anasluqman089/Miirin/BOM.csv

Quantity | Reference | Part | Prices ($) | Buy Links
1 | U1 | Seeed XIAO ESP32-S3 module | 7.50 | https://www.aliexpress.com/w/wholesale-Seeed-XIAO-ESP32-S3-module.html
1 | U2 | DFRobot DFPlayer Pro (DFR0768) | 8.50 | https://www.aliexpress.com/w/wholesale-DFRobot-DFPlayer-Pro-DFR0768.html
1 | - | 1.3 Inch OLED screen | 3.50 | https://www.aliexpress.com/w/wholesale-1.3-Inch-OLED-screen.html
1 | U3 | PCF8574P I2C I/O expander | 1.20 | https://www.aliexpress.com/w/wholesale-PCF8574P-I2C-IO-expander.html
1 | D1 | Common-anode RGB LED | 0.35 | https://www.aliexpress.com/w/wholesale-Common-anode-RGB-LED.html
1 | Q1 | P-channel MOSFET | 0.80 | https://www.aliexpress.com/w/wholesale-P-channel-MOSFET.html
1 | SW6 | Rotary encoder | 0.60 | https://www.aliexpress.com/w/wholesale-Rotary-encoder.html
1 | SW5 | Momentary push buttons | 0.15 | https://www.aliexpress.com/w/wholesale-Momentary-push-buttons.html
4 | SW1-SW4 | Cherry MX Keyboard Switches | 2.00 | https://www.aliexpress.com/w/wholesale-Cherry-MX-switch.html
1 | J1 | 4-pin socket/header for the OLED | 0.10 | https://www.aliexpress.com/w/wholesale-4-pin-socket-header-for-the-OLED.html
1 | J2 | Switched 3.5 mm audio jack | 0.50 | https://www.aliexpress.com/w/wholesale-Switched-3.5-mm-audio-jack.html
3 | R4-R6 | 220 Ohm resistors | 0.15 | https://www.aliexpress.com/w/wholesale-220-Ohm-resistors.html
2 | R2-R3 | 4.7 kOhm resistors | 0.10 | https://www.aliexpress.com/w/wholesale-4.7-kOhm-resistors.html
1 | R1 | 100 kOhm resistor | 0.05 | https://www.aliexpress.com/w/wholesale-100-kOhm-resistor.html
2 | - | 100 kOhm resistors | 0.10 | https://www.aliexpress.com/w/wholesale-100-kOhm-resistors.html
2 | C1-C2 | 10 uF ceramic capacitors | 0.30 | https://www.aliexpress.com/w/wholesale-10-uF-ceramic-capacitors.html
1 | C4 | 0.1 uF ceramic capacitor | 0.10 | https://www.aliexpress.com/w/wholesale-0.1-uF-ceramic-capacitor.html
1 | C5 | 470 uF polarized capacitor | 0.45 | https://www.aliexpress.com/w/wholesale-470-uF-polarized-capacitor.html
3 | H1-H3 | M2 screw | 0.30 | https://www.aliexpress.com/w/wholesale-M2-screw.html
5 | - | M2.5 screw | 0.50 | https://www.aliexpress.com/w/wholesale-M2.5-screw.html
1 | - | PCB | 8.60 | -
4 | - | 3D print | ~10.00 | -
Total | - | - | 45.85 | -
