anasluqman089/Miirin/CAD/Assembly 1.step

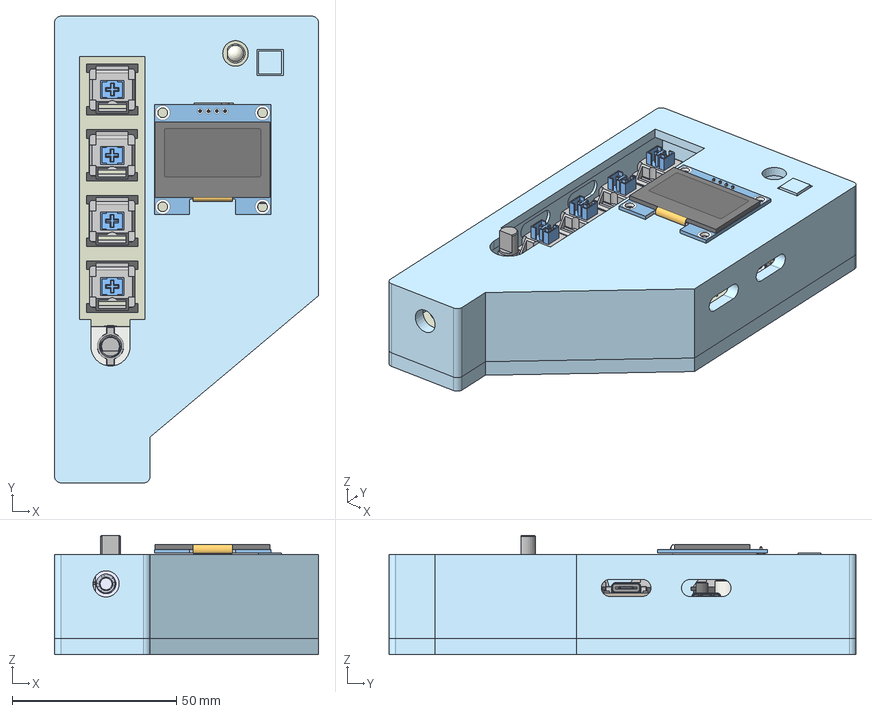
[picture p1: CAD file, 2026-10-24]
CAD/Assembly 1.step
80.4 x 142.1 x 36.4 mm
Pins:1__Solid1 x 8
Body-Move/Copy3
DFR0768 x 50
BOSS-EXTRUDE14_8_:1__K鰎per1
MAX1168CCEG+ x 25
R_Axial_DIN0207_L63mm_D25mm_P1016mm_Horizontal
Pins:1__K鰎per1_1
MIRROR2:1__K鰎per1
BOSS-EXTRUDE14_11_:1__K鰎per1
Shield:1__K鰎per1
ECS3201233QJESTR x 7
C_Disc_D43mm_W19mm_P500mm
Austragung1
BOSS-EXTRUDE14_2_:1__K鰎per1
Split2[2]
圆角3
C_Disc_D43mm_W19mm_P500mm_2
DIP-16_W7.62mm
R_Axial_DIN0207_L63mm_D25mm_P1016mm_Horizontal_5
圆角1
Body-Move/Copy1
Pins:1__K鰎per1
BOSS-EXTRUDE14_5_:1__K鰎per1
5077CR-16SMC2-BK-TR x 18
Button:1__Solid1 x 4
BOSS-EXTRUDE7_6_:1__K鰎per1
圆角4
Body:1__Solid1 x 4
TO-92_Inline_Narrow
BOSS-EXTRUDE14_7_:1__K鰎per1
CUT-EXTRUDE5:1__K鰎per1
SW_PUSH_6mm
Body:1__K鰎per1_1
R_Axial_DIN0207_L63mm_D25mm_P1016mm_Horizontal_2
BOSS-EXTRUDE7_3_:1__K鰎per1
BOSS-EXTRUDE14_4_:1__K鰎per1
BOSS-EXTRUDE14_9_:1__K鰎per1
BOSS-EXTRUDE7_1_:1__K鰎per1
BOSS-EXTRUDE7_8_:1__K鰎per1
BOSS-EXTRUDE7_5_:1__K鰎per1
Move Face1
R_Axial_DIN0207_L63mm_D25mm_P1016mm_Horizontal_1
BOSS-EXTRUDE7_4_:1__K鰎per1
BOSS-EXTRUDE7_2_:1__K鰎per1
BOSS-EXTRUDE14_10_:1__K鰎per1
PinHeader_1x04_P254mm_Horizontal
BOSS-EXTRUDE14_6_:1__K鰎per1
R_Axial_DIN0207_L63mm_D25mm_P1016mm_Horizontal_3
LED_D5.0mm-4
Pins:1__K鰎per4
Split2[4]
C_Disc_D43mm_W19mm_P500mm_1
圆角2
Miirin_PCB
圆角17
BOSS-EXTRUDE14_3_:1__K鰎per1
BOSS-EXTRUDE14_12_:1__K鰎per1
BOSS-EXTRUDE14_1_:1__K鰎per1
Pins:1__K鰎per3_1
CP_Radial_D80mm_P350mm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
