anasluqman089/Miirin/PCB/Miirin.step

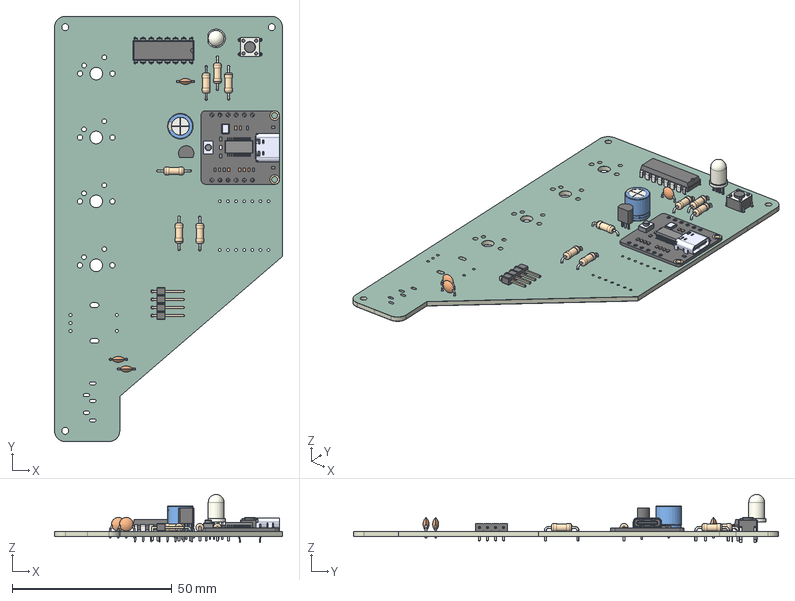
[picture p2: CAD file, 2026-10-24]
PCB/Miirin.step
71.4 x 133.1 x 15.1 mm
R_Axial_DIN0207_L63mm_D25mm_P1016mm_Horizontal x 6
DFR0768
5077CR-16SMC2-BK-TR
ECS3201233QJESTR
MAX1168CCEG+
SW_PUSH_6mm
C_Disc_D43mm_W19mm_P500mm x 3
PinHeader_1x04_P254mm_Horizontal
DIP-16_W7.62mm
TO-92_Inline_Narrow
LED_D5.0mm-4
CP_Radial_D80mm_P350mm
Miirin_soldermask x 2
Miirin_PCB
