anasluqman089/Miirin/Production/STL/Part Studio 1 - Case.stl

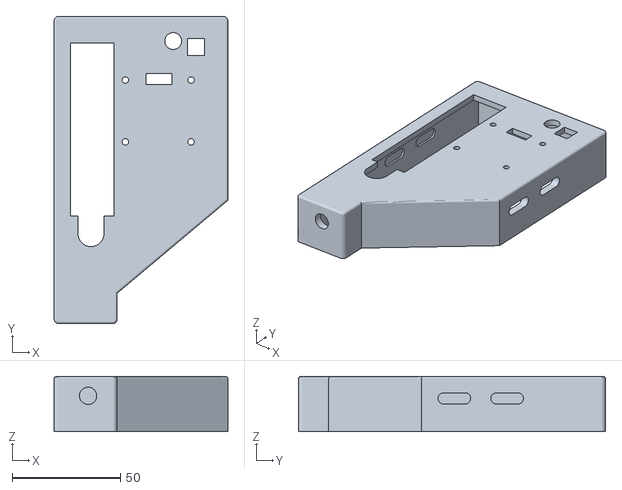
[picture p3: CAD file, 2026-10-27]
Production/STL/Part Studio 1 - Case.stl
80.4 x 142.1 x 25.5
