anasluqman089/Miirin/CAD/Part Studio 1 - Case & Flush Button.step

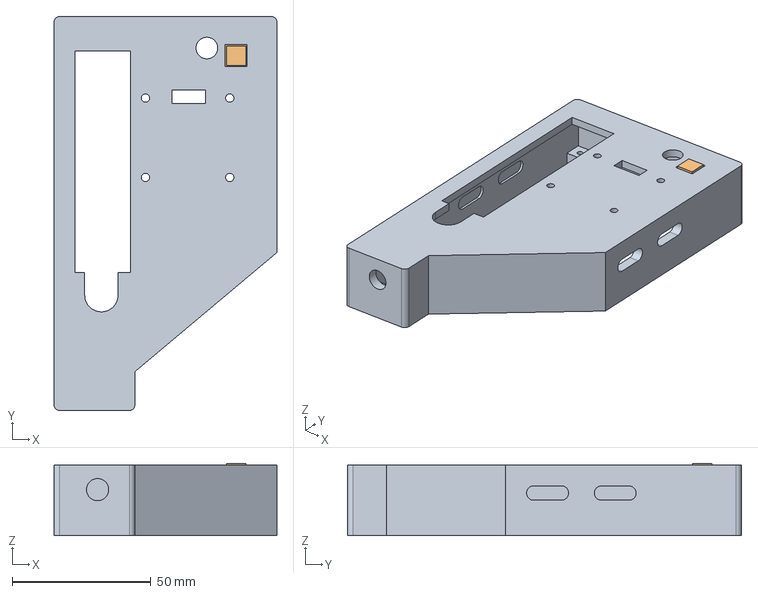
[picture p4: CAD file, 2026-10-24]
CAD/Part Studio 1 - Case & Flush Button.step
80.4 x 142.1 x 26.0 mm
