anasluqman089/Miirin/Production/STL/Part Studio 1 - Back Lid.stl

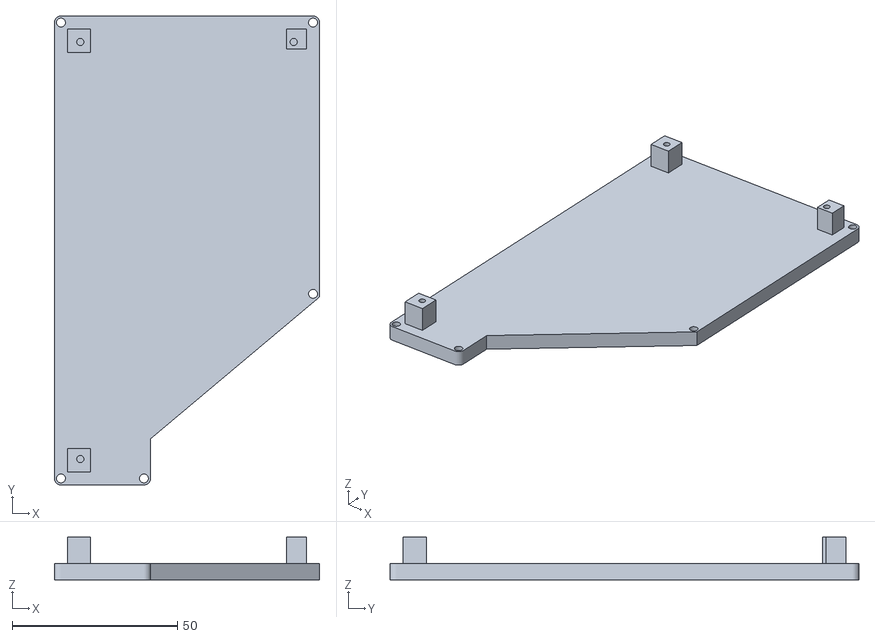
[picture p5: CAD file, 2026-10-27]
Production/STL/Part Studio 1 - Back Lid.stl
80.4 x 142.1 x 13.0
