anasluqman089/Miirin/CAD/Part Studio 1 - Back Lid.step

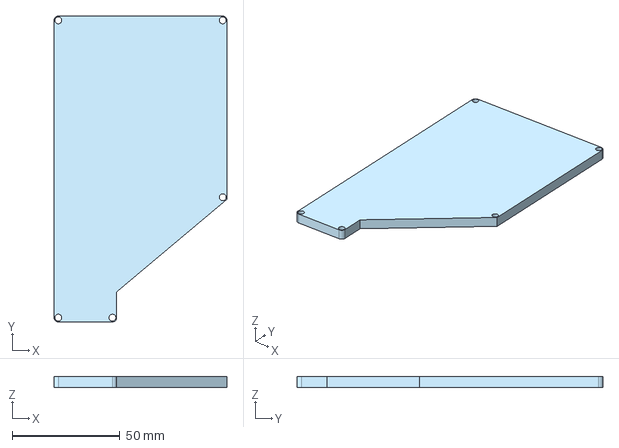
[picture p6: CAD file, 2026-10-24]
CAD/Part Studio 1 - Back Lid.step
80.4 x 142.1 x 5.00 mm
