anasluqman089/Miirin/Production/STL/Part Studio 1 - Flush Button.stl

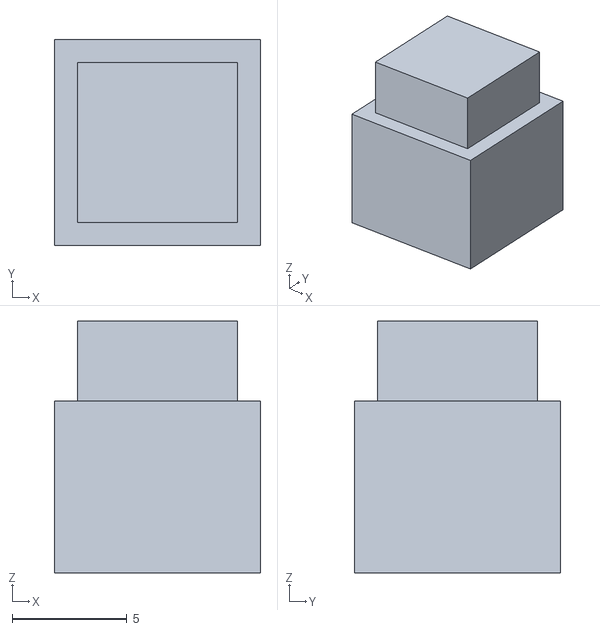
[picture p7: CAD file, 2026-10-24]
Production/STL/Part Studio 1 - Flush Button.stl
9.00 x 9.00 x 11.0
