anasluqman089/Miirin/CAD/Part Studio 1.step

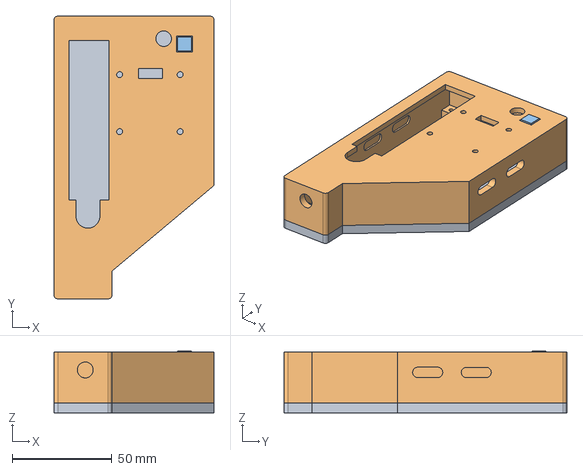
[picture p8: CAD file, 2026-10-24]
CAD/Part Studio 1.step
80.4 x 142.1 x 31.0 mm
