anasluqman089/Miirin/PCB/Miirin.kicad_pcb

## KiCad design PCB/Miirin.kicad_pcb (2026-10-24)

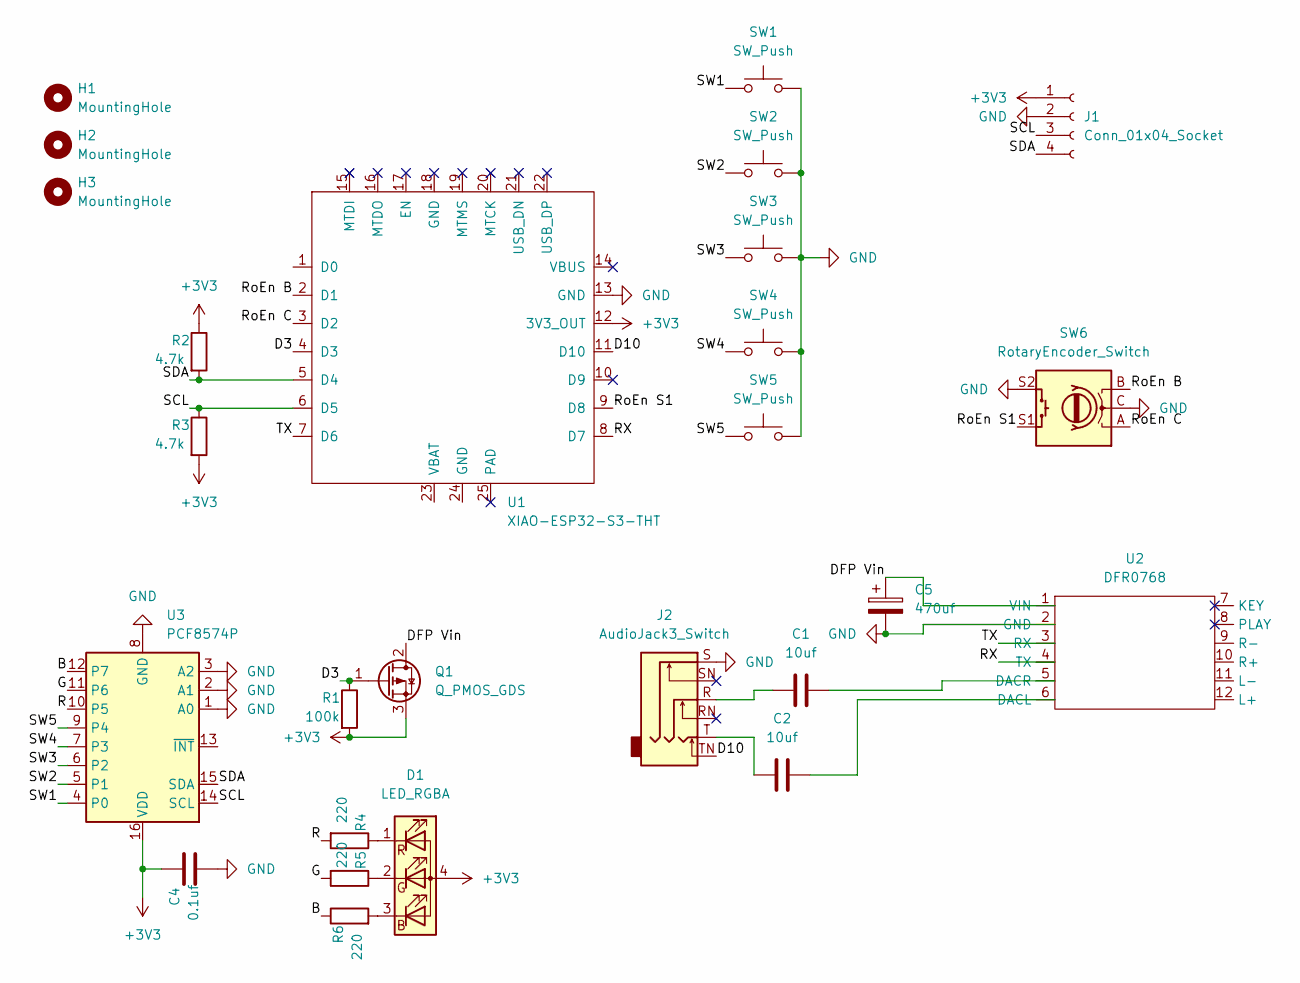
[picture p9: schematic Miirin.kicad_sch]

Parts:
C1, C2: 10uf; C_Disc_D4.3mm_W1.9mm_P5.00mm
C4: 0.1uf; C_Disc_D4.3mm_W1.9mm_P5.00mm
C5: 470uf; CP_Radial_D8.0mm_P3.50mm
D1: LED_RGBA; LED_D5.0mm-4_RGB
H1, H2, H3: MountingHole; MountingHole_2.2mm_M2
J1: Conn_01x04_Socket; PinHeader_1x04_P2.54mm_Horizontal
J2: AudioJack3_Switch; Jack_3.5mm_CUI_SJ1-3535NG_Horizontal
Q1: Q_PMOS_GDS; TO-92_Inline
R1: 100k; R_Axial_DIN0207_L6.3mm_D2.5mm_P10.16mm_Horizontal
R2, R3: 4.7k; R_Axial_DIN0207_L6.3mm_D2.5mm_P10.16mm_Horizontal
R4, R5, R6: 220; R_Axial_DIN0207_L6.3mm_D2.5mm_P10.16mm_Horizontal
SW1, SW2, SW3, SW4: SW_Push; SW_Cherry_MX_1.00u_PCB
SW5: SW_Push; SW_PUSH_6mm
SW6: RotaryEncoder_Switch; RotaryEncoder_Alps_EC11E-Switch_Vertical_H20mm
U1: XIAO-ESP32-S3-THT; XIAO-ESP32-S3-DIP
U2: DFR0768
U3: PCF8574P; DIP-16_W7.62mm

Connections:
+3V3: C4.2, D1.4 (A), J1.1, Q1.3 (S), R1.2, R2.1, R3.2, U1.12 (3V3_OUT), U3.16 (VDD)
/B: R6.1, U3.12 (P7)
/D3: Q1.1 (G), R1.1, U1.4 (D3)
/D10: J2.TN, U1.11 (D10)
/DFP Vin: C5.1, Q1.2 (D), U2.1 (VIN)
/G: R5.2, U3.11 (P6)
/R: R4.2, U3.10 (P5)
/RX: U1.8 (D7), U2.4 (TX)
/RoEn B: SW6.B, U1.2 (D1)
/RoEn C: SW6.A, U1.3 (D2)
/RoEn S1: SW6.S1, U1.9 (D8)
/SCL: J1.3, R3.1, U1.6 (D5), U3.14 (SCL)
/SDA: J1.4, R2.2, U1.5 (D4), U3.15 (SDA)
/SW1: SW1.1, U3.4 (P0)
/SW2: SW2.1, U3.5 (P1)
/SW3: SW3.1, U3.6 (P2)
/SW4: SW4.1, U3.7 (P3)
/SW5: SW5.1, U3.9 (P4)
/TX: U1.7 (D6), U2.3 (RX)
GND: C4.1, C5.2, J1.2, J2.S, SW1.2, SW2.2, SW3.2, SW4.2, SW5.2, SW6.C, SW6.S2, U1.13 (GND), U2.2 (GND), U3.1 (A0), U3.2 (A1), U3.3 (A2), U3.8 (GND)
unnamed: C1.1, J2.R
unnamed: C2.1, J2.T
unnamed: D1.3 (BK), R6.2
unnamed: D1.2 (GK), R5.1
unnamed: D1.1 (RK), R4.1
unnamed: C2.2, U2.6 (DACL)
unnamed: C1.2, U2.5 (DACR)

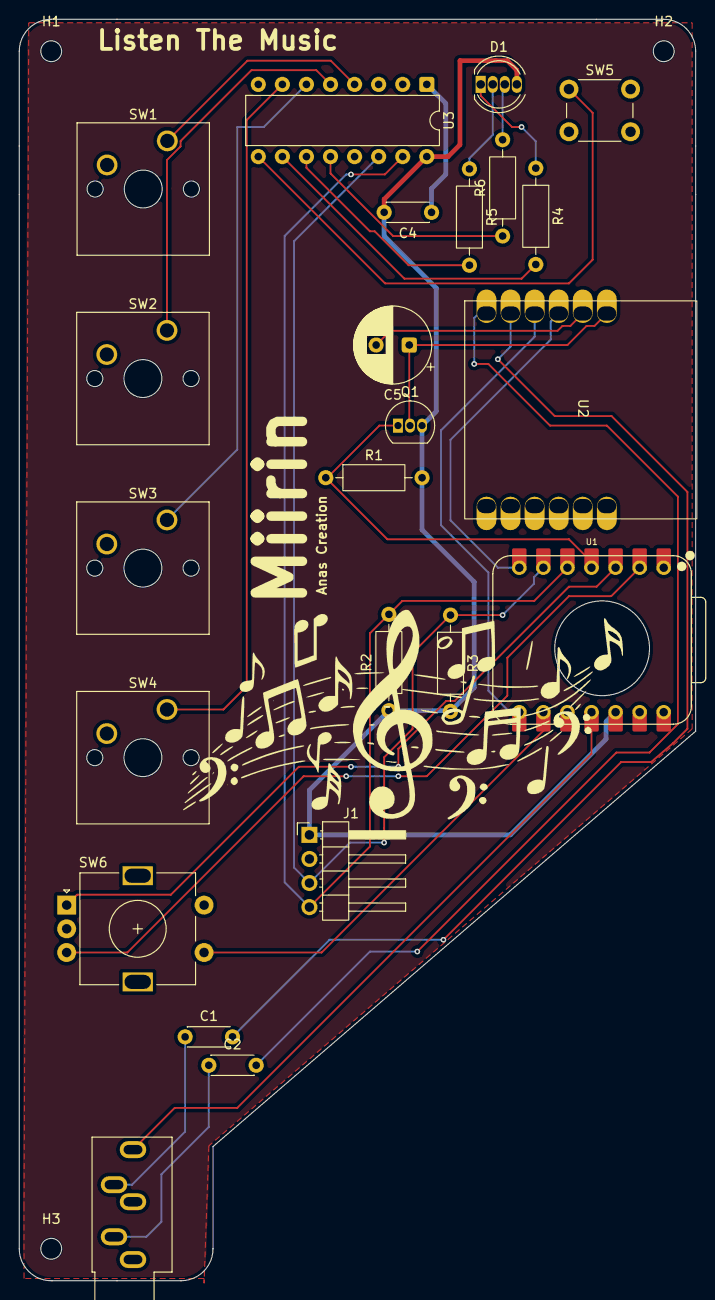
[picture p10: board Miirin.kicad_pcb from above]

Board: 2 copper layers, 71.4 x 133.1 mm, 26 parts (0 on the bottom side), 27 nets.
