anasluqman089/Miirin/(commit log)

2026-10-16 Add Gerber files and BOM for Miirin project
    - Created Miirin-PTH.drl for plated through-hole drill specifications.
    - Added Miirin-job.gbrjob to define job attributes and file specifications for the PCB.
    - Introduced bom.csv listing components required for the Miirin project, including quantities and references.
    [Assembly 1.step, Miirin PCB.step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]
2026-10-16 Add prices and buy links to BOM.csv
    Updated BOM to include prices and buy links for components.
    [BOM.csv, bom.csv]
2026-10-16 Updated the BOM with correct links
    [BOM.csv]
2026-10-16 Add bill of materials and update getting started section
    Added a bill of materials section with estimated costs and links for components. Updated the getting started section with instructions for uploading code.
2026-10-16 Revise uploading instructions and add image sections
    Updated the uploading instructions and added sections for images, schematic, PCB, and CAD.
2026-10-17 Add CAD link section to README
    Added CAD link for reference in the README.
2026-10-17 Revise bill of materials with updated prices
    Updated bill of materials with new pricing and links.
2026-10-24 Updated the PCB design and CAD file with the new one. Added .stl file of the case. Updated the BOM in BOM.csv and README.md
    [Assembly 1.step, BOM.csv, Miirin PCB.step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]
2026-10-26 update the cad to make it a M2.5 screw
    [BOM.csv, Part Studio 1 - Back Lid.stl, Part Studio 1 - Case.stl, Part Studio 1 - Lid.stl]
2026-10-27 Update the case
    [Part Studio 1 - Back Lid.stl, Part Studio 1 - Case.stl, Part Studio 1 - Lid.stl]
